masnth/EE474/(commit log)

2017-03-09 Cardio with ADC trigger by PDB
2017-03-09 Try using filter to refine result
2017-09-15 Final upload for cardio devices
